bonkas/pc-ir-remote-ESP32/hardware/v2/readme.md

This is a work in progress, this will be updated once completed.

The idea of this hardware version is to replace the relays and associated components with simple mosfets for switching.
