bonkas/pc-ir-remote-ESP32/(commit log)

2026-02-28 Initial commit — ESP32-C3 IR remote, ESPHome + Arduino firmware, KiCad schematic
    [bom.csv]
2026-02-28 Update firmware, docs, and project config
    - Restructure Arduino sketch into labelled sections; extract handleIR()
    from loop(); add non-blocking learn-mode LED blink pattern; add
    configurable STATUS_LED_PIN with external LED support on GPIO7
    - Fix platformio.ini: move src_dir to [platformio] section
    - Rewrite ESPHome YAML to match current hardware (correct board, pins,
    both relays, physical buttons, status LED, IR automation examples)
    - Add firmware/esphome/secrets.yaml.example template
    - Rewrite README with how-it-works, build requirements, PC connection
    guide, firmware comparison table, and full setup instructions
    - Rewrite docs/setup.md with current workflows fo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
2026-02-28 Update README: clarify power options and add docs section
    - Add Documentation table signposting assembly.md, setup.md and
    CONTEXT.md with descriptions and when to read each
    - Add external USB-C power option alongside internal motherboard
    USB header in How It Works and Features sections
2026-03-01 Hide binary sensors from HA UI using internal: true
    - Mark physical buttons (GPIO5, GPIO6) and IR remote button entries
    as internal: true — entities remain functional but no longer appear
    in Home Assistant as sensors with history logs
2026-03-01 3 documentation files updated to match current code:
    - CONTEXT.md — Major overhaul: replaced the outdated ESPHome skeleton (wrong board esp32dev, wrong pins GPIO14/GPIO12,
    old OTA format) with an accurate overview of the current config; removed hardware/kicad/ from repo structure (it's
    gitignored); updated publishing intent; replaced all stale TODOs with actual remaining work.
    - docs/setup.md — Two fixes: added internal: true to the IR binary_sensor examples (step 4); corrected the
    remote_receiver list format in the "disable dumping" snippet (step 5).
    - README.md — Replaced the old on_nec: IR learning snippet with the correct binary_sensor approach including internal:
    t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
2026-03-02 Add PC sleep state detection (On / Sleeping / Off)
    firmware/arduino/pc-ir-remote/pc-ir-remote.ino
    - Replaced the simple bool pcPowerState / checkPcPowerState() with a three-state PcState enum (PC_UNKNOWN / PC_OFF /
    PC_ON / PC_SLEEPING) and checkPcState()
    - Logic tracks ledLastHigh and ledLastLow timestamps — whichever has been un-updated for 5 seconds determines the
    state; toggling = SLEEPING
    - Added PC_STATE_THRESHOLD_MS 5000 to CONFIGURATION
    - setup() initialises both timestamps to millis() so state resolves naturally after 5 seconds of monitoring
    firmware/esphome/pc-ir-remote.yaml
    - Added on_boot to initialise globals at startup
    - Added globals: section (led_last_hi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
    [pc-ir-remote.ino]
2026-06-18 updated configs for new PCB design.
    [pc-ir-remote-ESP32-B_Cu.gbr, pc-ir-remote-ESP32-B_Mask.gbr, pc-ir-remote-ESP32-B_Paste.gbr, pc-ir-remote-ESP32-B_Silkscreen.gbr, pc-ir-remote-ESP32-Edge_Cuts.gbr, pc-ir-remote-ESP32-F_Cu.gbr, pc-ir-remote-ESP32-F_Mask.gbr, pc-ir-remote-ESP32-F_Paste.gbr]
2026-06-18 Adjusted button press "on time" to 250ms
2026-07-09 Adjust button press duration to 100ms to avoid issues with some devices.
2026-07-26 Removed unneeded test files from the blink-test directory in the Arduino firmware project. These files were not necessary for the main functionality and have been deleted to clean up the repository.
2026-07-26 Added a test sketch to test basic functionality of PCB
2026-07-26 Fix onboard LED pin mismatch on ESP32-C3 SuperMini boards STATUS_LED_PIN was set to LED_BUILTIN in both sketches, which PlatformIO's lolin_c3_mini board profile resolves to GPIO7. The onboard LED on 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
    [pc-ir-relay-test.ino]
2026-07-26 Updated onbaord LED pin to GPIO8 for ESP32-C3 SuperMini boards. The Arduino LED_BUILTIN macro resolves to GPIO7 for PlatformIO's "lolin_c3_mini" board (genuine Wemos/Lolin pinout), which does NOT mat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
    [pc-ir-remote.ino]
2026-07-26 Update BOM and gerbers to final PCB revision
    Replaces the early-planning BOM and gerber set with the exports from
    the finalized, fabricated, and hardware-validated PCB revision.
    [bom.csv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]
2026-07-26 Add licenses, fix GPIO7/8 LED docs, and stop tracking CONTEXT.md
    - Add MIT LICENSE for firmware and CERN-OHL-P v2 hardware/LICENSE,
    replacing the "TBD" placeholder in README.
    - Reconcile README/docs/firmware comments on the status LED pin: the
    Arduino sketch now defaults STATUS_LED_PIN to the literal 8 (see
    prior commit), so docs describing GPIO7 as the default were stale.
    - Add a "Hardware Bring-Up Test" section to docs/setup.md pointing at
    firmware/arduino/pc-ir-relay-test/, previously undocumented.
    - Update README Project Status now that the PCB is fabricated and
    validated on real hardware, not just breadboard.
    - Stop tracking CONTEXT.md and remove references to it — it's a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
    [pc-ir-remote.ino]
2026-07-26 Version hardware/ into relay-v1/ to make room for a future MOSFET revision
    Moves gerbers/, gerbers.zip, bom/, and LICENSE under hardware/relay-v1/
    so a planned MOSFET-based revision can live alongside it in its own
    hardware/ subfolder later instead of overwriting the relay version.
    Updates all path references in README.md and CONTEXT.md, and widens
    the .gitignore KiCad rule to hardware/*/kicad/ for future revisions.
    [bom.csv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]
